shanjiancaofu/smart-gas-monitor/hardware/schematic/原理图.png

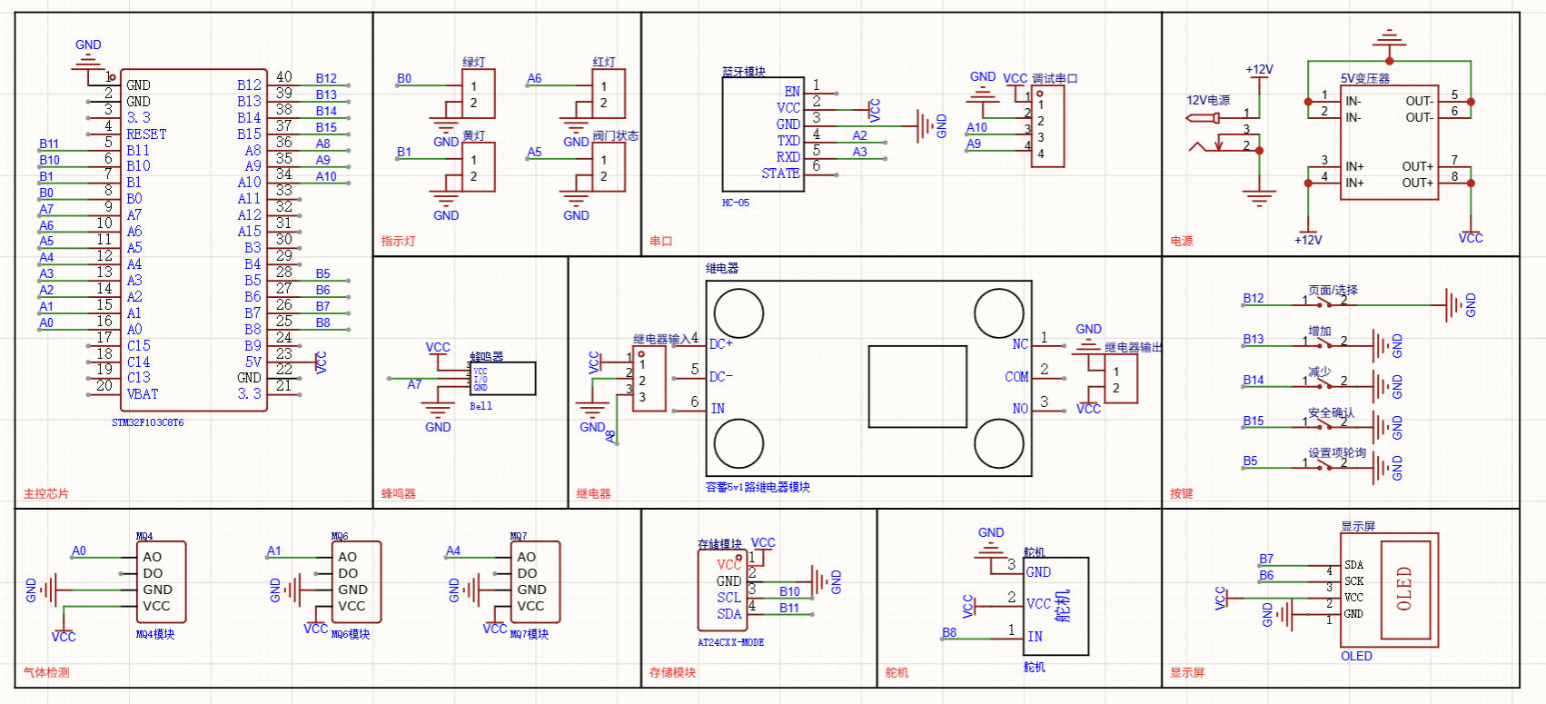
hardware/schematic/原理图.png
