shanjiancaofu/smart-gas-monitor/docs/题目及嵌入式元器件清单.xls

序号 | 自选题目 | 基础功能 | 需要基础元器件 | 型号 | 扩展功能 | 扩展硬件 | 型号
例：第１组 | 智能温度监控系统 | 实时采集、显示环境温度、阈值及系统工作状态；温度超限声光报警 + 风扇自动调节（制冷 / 制热）；按键设置温限阈值，周期性采样（频率可调）；串口上传温度数据至 PC 存储（含报警状态） | 开发板 x1 | STM32F103C8T6 | 蓝牙通信、数据断电存储、多个温度传感器（多点监控）、实现温度自控制 | 蓝牙模块 x1 | HC-06
 |  |  | 温度传感器 x1 | DS18B20 |  | SD 卡模块 x1 | SD卡模块
 |  |  | 蜂鸣器 x1 | 有源/无源蜂鸣器 |  | 按键 x4
 |  |  | LED x3 |  |  | 继电器模块 x1 | 继电器模块
 |  |  | 电机 x1 | 步进电机28BYJ4+ULN2003 |  | 温度传感器 x3 | DS18B20
 |  |  | 电机驱动模块 x1 | L298N模块
 |  |  | 小风扇 x1 | L9110风扇传感器模块
 |  |  | USB 转串口模块 x1 | CH340模块
 |  |  | 按键 x2 | 6*6*5四脚按键
 |  |  | OLED模块 x1 | 0.96寸，4管脚，OLED
 |  |  | 电阻若干
 |  |  | 电容若干
 | 智能燃气监测与自动防护系统 | 实时采集MQ-4、MQ-7、MQ-8三路燃气传感器数据，监测环境燃气浓度； 通过OLED显示燃气浓度、系统运行状态和报警信息； 当燃气浓度超过设定阈值时触发声光报警，并通过继电器模块模拟控制燃气阀门关闭； 支持按键切换工作模式、调整燃气报警阈值； 支持定时采样、串口通信功能。 | STM32F103C8T6开发板 ×1 | STM32F103C8T6 | 增加HC-05蓝牙通信，实现手机APP远程监控；APP端可查看实时燃气浓度、系统运行状态、阀门状态以及历史泄漏事件，并支持远程设置报警阈值、采样周期、报警时间等参数。 增加防误操作设计，燃气报警后关闭阀门，需要按键确认并且燃气浓度恢复正常后才能重新开启。 增加数据存储功能，使用AT24C02 EEPROM保存系统参数和历史泄漏事件，可通过串口查询历史数据并在OLED显示。 | 蓝牙模块 ×1 | HC-05
 |  |  | MQ-4燃气传感器 ×1 | MQ-4 |  | EEPROM存储模块 ×1 | AT24C02
 |  |  | MQ-7燃气传感器 ×1 | MQ-7
 |  |  | MQ-8燃气传感器 ×1 | MQ-8
 |  |  | OLED显示模块 ×1 | 0.96寸 I2C OLED
 |  |  | 有源蜂鸣器 ×1 | 有源蜂鸣器
 |  |  | LED ×3 | LED
 |  |  | 独立按键 ×4 | 两脚按键
 |  |  | 5V继电器模块 ×1 | 5V继电器模块
 |  |  | 电源开关 ×1 | SS-12D06
 |  |  | USB-TTL串口模块 ×1 | CH340 USB-TTL
 |  |  | 电阻若干
