shanjiancaofu/smart-gas-monitor/(list of files, drawings)

Other design files:
hardware/proteus/燃气检测.pdsprj
