shanjiancaofu/smart-gas-monitor/stm32f103/Core/Src/main.c

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
/* Includes ------------------------------------------------------------------*/
#include "main.h"
#include "adc.h"
#include "i2c.h"
#include "tim.h"
#include "usart.h"
#include "gpio.h"

/* USER CODE BEGIN Includes */
#include "app.h"
#include "alarm/alarm.h"
#include "bsp_buzzer.h"
/* USER CODE END Includes */


void SystemClock_Config(void);
/* USER CODE BEGIN 0 */

/* Power is always present in the current hardware.  Hold the application at
 * a safe, inactive startup gate until KEY5 is pressed, then release it
 * before app_init() arms the normal warm-up/monitoring flow. */
static void wait_for_start_key(void)
{
  while (HAL_GPIO_ReadPin(KEY5_GPIO_Port, KEY5_Pin) == GPIO_PIN_SET)
  {
    HAL_Delay(20);
  }
  HAL_Delay(30);
  while (HAL_GPIO_ReadPin(KEY5_GPIO_Port, KEY5_Pin) == GPIO_PIN_RESET)
  {
    HAL_Delay(10);
  }
}

/* USER CODE END 0 */

/**
  * @brief  The application entry point.
  * @retval int
  */
int main(void)
{

  /* MCU Configuration--------------------------------------------------------*/

  /* Reset of all peripherals, Initializes the Flash interface and the Systick. */
  HAL_Init();

  /* Configure the system clock */
  SystemClock_Config();

  /* Initialize all configured peripherals */
  MX_GPIO_Init();
  MX_ADC1_Init();
  MX_I2C1_Init();
  MX_I2C2_Init();
  MX_USART1_UART_Init();
  MX_USART2_UART_Init();
  MX_TIM2_Init();
  MX_TIM4_Init();
  /* USER CODE BEGIN 2 */
  /* MX_GPIO_Init() 里那句 HAL_GPIO_WritePin 把 BUZZER_Pin 也拉低了，那是按高
   * 电平触发生成的。本项目的蜂鸣器低电平触发，所以上电到 alarm_init() 之间它会
   * 一直响；这里先摆回空闲电平，别等 app_init()。 */
  bsp_buzzer_set(false);
  wait_for_start_key();
  if (!app_init())
  {
    Error_Handler();
  }
  /* USER CODE END 2 */

  /* Infinite loop */
  /* USER CODE BEGIN WHILE */
  while (1)
  {
    /* USER CODE END WHILE */

    /* USER CODE BEGIN 3 */
    app_update();
  }
  /* USER CODE END 3 */
}

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
