shanjiancaofu/smart-gas-monitor/stm32f103/smart_gas_monitor.ioc

Mcu.UserName=STM32F103C8Tx
PA0-WKUP.GPIO_Label=MQ4_AO
PA0-WKUP.Signal=ADCx_IN0
PA1.GPIO_Label=MQ6_AO
PA1.Signal=ADCx_IN1
PA10.Signal=USART1_RX
PA13.Signal=SYS_JTMS-SWDIO
PA14.Signal=SYS_JTCK-SWCLK
PA2.Signal=USART2_TX
PA3.Signal=USART2_RX
PA4.GPIO_Label=MQ7_AO
PA4.Signal=ADCx_IN4
PA5.GPIO_Label=VALVE_LED
PA5.Signal=GPIO_Output
PA6.GPIO_Label=LED_RED
PA6.Signal=GPIO_Output
PA7.GPIO_Label=BUZZER
PA7.Signal=GPIO_Output
PA8.GPIO_Label=RELAY
PA8.Signal=GPIO_Output
PA9.Signal=USART1_TX
PB0.GPIO_Label=LED_GREEN
PB0.Signal=GPIO_Output
PB1.GPIO_Label=LED_YELLOW
PB1.Signal=GPIO_Output
PB10.Signal=I2C2_SCL
PB11.Signal=I2C2_SDA
PB12.GPIO_Label=KEY1
PB12.Signal=GPXTI12
PB13.GPIO_Label=KEY2
PB13.Signal=GPXTI13
PB14.GPIO_Label=KEY3
PB14.Signal=GPXTI14
PB15.GPIO_Label=KEY4
PB15.Signal=GPXTI15
PB5.GPIO_Label=KEY5
PB5.Signal=GPXTI5
PB6.Signal=I2C1_SCL
PB7.Signal=I2C1_SDA
PB8.Signal=S_TIM4_CH3
PD0-OSC_IN.Signal=RCC_OSC_IN
PD1-OSC_OUT.Signal=RCC_OSC_OUT
