shanjiancaofu/smart-gas-monitor/stm32f103/Core/Inc/main.h

#define MQ4_AO_Pin GPIO_PIN_0
#define MQ4_AO_GPIO_Port GPIOA
#define MQ6_AO_Pin GPIO_PIN_1
#define MQ6_AO_GPIO_Port GPIOA
#define MQ7_AO_Pin GPIO_PIN_4
#define MQ7_AO_GPIO_Port GPIOA
#define VALVE_LED_Pin GPIO_PIN_5
#define VALVE_LED_GPIO_Port GPIOA
#define LED_RED_Pin GPIO_PIN_6
#define LED_RED_GPIO_Port GPIOA
#define BUZZER_Pin GPIO_PIN_7
#define BUZZER_GPIO_Port GPIOA
#define LED_GREEN_Pin GPIO_PIN_0
#define LED_GREEN_GPIO_Port GPIOB
#define LED_YELLOW_Pin GPIO_PIN_1
#define LED_YELLOW_GPIO_Port GPIOB
#define KEY1_Pin GPIO_PIN_12
#define KEY1_GPIO_Port GPIOB
#define KEY1_EXTI_IRQn EXTI15_10_IRQn
#define KEY2_Pin GPIO_PIN_13
#define KEY2_GPIO_Port GPIOB
#define KEY2_EXTI_IRQn EXTI15_10_IRQn
#define KEY3_Pin GPIO_PIN_14
#define KEY3_GPIO_Port GPIOB
#define KEY3_EXTI_IRQn EXTI15_10_IRQn
#define KEY4_Pin GPIO_PIN_15
#define KEY4_GPIO_Port GPIOB
#define KEY4_EXTI_IRQn EXTI15_10_IRQn
#define RELAY_Pin GPIO_PIN_8
#define RELAY_GPIO_Port GPIOA
#define KEY5_Pin GPIO_PIN_5
#define KEY5_GPIO_Port GPIOB
#define KEY5_EXTI_IRQn EXTI9_5_IRQn
