shanjiancaofu/smart-gas-monitor/tests/test_alarm.c

#include "alarm/alarm.h"
#include "bsp_led.h"
#include "bsp_buzzer.h"
#include "bsp_relay.h"
#include <assert.h>
#include <stdio.h>

static bool relay, servo_open, buzzer, green_led, yellow_led, red_led, valve_led;
void bsp_fan_set(bool on) { relay = on; }
void bsp_servo_set(bool open) { servo_open = open; }
void bsp_buzzer_set(bool on) { buzzer = on; }
void bsp_led_valve(bool open) { valve_led = open; }
void bsp_led_set(bool green, bool yellow, bool red, bool valve)
{
    green_led = green;
    yellow_led = yellow;
    red_led = red;
    valve_led = valve;
}

int main(void)
{
    alarm_t alarm;
    gas_t gas;
    uint32_t start = UINT32_MAX - 250u;

    gas_init(&gas, NULL, 0);
    alarm_init(&alarm);
    /* 正常上电：全部不动作，风扇也不转。排风是 FAULT/ALARM 才有的行为，
     * alarm_force_safe() 那条路径才开风扇，两者不能混。 */
    assert(!relay && !buzzer && !valve_led);
    alarm_update(&alarm, &gas, 0);
    assert(!relay && !servo_open && !valve_led && !buzzer);
    gas.config.lockout = true;
    gas.latched = true;
    alarm_update(&alarm, &gas, 0);
    assert(relay && !servo_open && !valve_led);
    gas.config.lockout = false;
    gas.latched = false;
    gas.state = GAS_NORMAL;
    alarm_update(&alarm, &gas, 0);
    assert(!relay && servo_open && green_led && valve_led && !buzzer);
    gas.state = GAS_WARNING;
    alarm_update(&alarm, &gas, 1);
    assert(!relay && servo_open && yellow_led && !red_led);

    gas.state = GAS_ALARM;
    gas.latched = true;
    gas.alarm_mask = 1u;
    alarm_update(&alarm, &gas, start);
    assert(relay && !servo_open && !valve_led && red_led && buzzer);

    /* 单滴刚好响 BEEP_ON_TICKS 个节拍，之后到下一滴起点之间是安静的。 */
    /* The 10 ms timer ISR must turn the buzzer off even while the main loop
       is blocked in a slow Soft-I2C OLED transfer. */
    alarm_tick_isr(&alarm, start + BEEP_ON_TICKS);
    assert(!buzzer);

    /* 多一路报警会重新起一拍，蜂鸣器立刻再响。 */
    gas.alarm_mask = 3u;
    alarm_update(&alarm, &gas, start + BEEP_ON_TICKS + 10u);
    assert(buzzer);

    /* 默认档位是 5 秒，从重新起拍算起 500 个节拍之后不再响，红灯和关阀保持。
     * 这几个时刻都从 BEEP_* 常量推出来，调档位时测试跟着走。 */
    alarm_update(&alarm, &gas, start + BEEP_ON_TICKS + 10u + 500u);
    assert(!buzzer && red_led && relay);
    alarm_update(&alarm, &gas, start + BEEP_ON_TICKS + 10u + 1000u);
    assert(!buzzer);

    gas.state = GAS_SAFE_WAIT;
    alarm_update(&alarm, &gas, 1000);
    assert(relay && !servo_open && !buzzer && yellow_led);
    gas.state = GAS_FAULT;
    alarm_update(&alarm, &gas, 1001);
    assert(buzzer && relay && !servo_open && red_led);
    alarm_update(&alarm, &gas, 1001u + FAULT_BEEP_ON_TICKS);
    assert(!buzzer && relay && !servo_open && red_led);
    gas.config.buzzer = GAS_BUZZER_OFF;
    alarm_update(&alarm, &gas, 1002);
    assert(!buzzer);
    gas.config.buzzer = GAS_BUZZER_ALWAYS;
    alarm_update(&alarm, &gas, 1001u + 128u * 1000u);
    assert(buzzer);
    alarm_force_safe();
    assert(relay && !buzzer && !valve_led);
    puts("PASS: alarm output mapping/timer/wraparound/off/always/safe");
    return 0;
}
