shanjiancaofu/smart-gas-monitor/tests/test_gas_monitor.c

#include "gas/gas_monitor.h"
#include <assert.h>
#include <stdio.h>
#include <string.h>

static void sample(gas_monitor_t *m, uint32_t now, uint16_t a, uint16_t b, uint16_t c)
{
    uint16_t values[GAS_COUNT] = {a, b, c};
    gas_monitor_sample(m, values, true, now);
}
/* 跑完一次干净的预热；本函数返回时阀门应当已经打开。 */
static void run_to_normal(gas_monitor_t *m, uint32_t start)
{
    uint32_t t;
    gas_monitor_init(m, NULL, start);
    for (t = 0; t <= GAS_WARMUP_MS + GAS_SAFE_HOLD_MS; t += 100)
        sample(m, start + t, 500, 500, 500);
    assert(m->state == GAS_NORMAL);
    assert(gas_monitor_valve_open(m));
}
static void test_states(void)
{
    gas_monitor_t m;
    uint32_t t;
    unsigned i;
    for (i = 0; i < GAS_COUNT; ++i) {
        uint16_t values[GAS_COUNT] = {500, 500, 500};
        run_to_normal(&m, 0);
        values[i] = gas_warning_threshold(m.config.alarm[i]);
        gas_monitor_sample(&m, values, true, 63100);
        assert(m.state == GAS_WARNING && gas_monitor_valve_open(&m));
        values[i] = m.config.alarm[i];
        gas_monitor_sample(&m, values, true, 63200);
        assert(m.state == GAS_ALARM && !gas_monitor_valve_open(&m));
        assert(m.alarm_mask == (1u << i) && m.alarm_count == 1);
        m.dirty = false;
        sample(&m, 63250, values[0], values[1], values[2]);
        assert(m.state == GAS_ALARM && !m.dirty);
        gas_monitor_key(&m, 4, 63250);
        assert(!gas_monitor_valve_open(&m));
        for (t = 63300; t <= 66300; t += 100) sample(&m, t, 500, 500, 500);
        assert(m.state == GAS_SAFE_WAIT && m.reset_ready);
        assert(!gas_monitor_valve_open(&m));
        gas_monitor_key(&m, 4, 66300);
        assert(gas_monitor_valve_open(&m));
    }
    run_to_normal(&m, 0);
    gas_monitor_tick(&m, 63500);
    assert(m.state == GAS_FAULT && !gas_monitor_valve_open(&m));
    assert(m.config.lockout && m.dirty);
    m.dirty = false;
    gas_monitor_tick(&m, 63501);
    assert(!m.dirty);
    sample(&m, 63600, 500, 500, 500);
    gas_monitor_key(&m, 4, 63600);
    assert(!gas_monitor_valve_open(&m));
    gas_monitor_sample(&m, NULL, false, 63700);
    assert(m.state == GAS_FAULT);
    sample(&m, 63800, 4096, 0, 0);
    assert(m.state == GAS_FAULT);
    run_to_normal(&m, 0);
    sample(&m, 64000, 500, 500, 500);
    assert(m.state == GAS_SAFE_WAIT && !gas_monitor_valve_open(&m));
    assert(!m.reset_ready);
    /* 预热计时和安全计时都要跨过回绕点。 */
    run_to_normal(&m, UINT32_MAX - 61000u);
}
static void test_power_up_opens(void)
{
    gas_monitor_t m;
    uint32_t t;
    gas_monitor_init(&m, NULL, 0);
    for (t = 0; t < GAS_WARMUP_MS; t += 100) {
        sample(&m, t, 500, 500, 500);
        assert(m.state == GAS_WARMUP);
        assert(!gas_monitor_valve_open(&m));
    }
    sample(&m, GAS_WARMUP_MS, 500, 500, 500);
    assert(m.state == GAS_NORMAL && gas_monitor_valve_open(&m));
    /* 安全保持窗口是用来解除锁存的，不是开阀的前置条件。 */
    assert(!m.reset_ready);
}
static void test_no_fault_before_first_sample(void)
{
    gas_monitor_t m;
    gas_monitor_init(&m, NULL, 1000);
    gas_monitor_tick(&m, 1000);
    assert(m.state == GAS_WARMUP && !m.latched);
    /* 一旦成功采过样，再丢掉采样就重新算故障。 */
    sample(&m, 1100, 500, 500, 500);
    gas_monitor_tick(&m, 1100 + gas_sample_timeout_ms(&m));
    assert(m.state == GAS_FAULT && m.latched);
}
static void test_failed_attempt_is_a_fault(void)
{
    gas_monitor_t m;
    uint32_t t;
    /* 开机时就坏掉的 ADC 必须报故障，而不是永远停在预热：「还没有读数」和
     * 「读到了一次失败的读数」是两回事。 */
    gas_monitor_init(&m, NULL, 0);
    gas_monitor_sample(&m, NULL, false, 100);
    assert(m.state == GAS_FAULT && m.latched);
    assert(!gas_monitor_valve_open(&m));
    /* 它和其它锁存走同一条恢复规则：先回到洁净空气，再按 KEY4。 */
    for (t = 200; t <= 100000; t += 100) sample(&m, t, 500, 500, 500);
    assert(m.state == GAS_SAFE_WAIT && m.reset_ready);
    assert(!gas_monitor_valve_open(&m));
    gas_monitor_key(&m, 4, 100000);
    assert(gas_monitor_valve_open(&m));
}
static void test_persisted_lockout(void)
{
    gas_monitor_t m;
    gas_config_t c;
    uint32_t t;
    gas_config_defaults(&c);
    c.lockout = true;
    gas_monitor_init(&m, &c, 0);
    assert(m.latched && !gas_monitor_valve_open(&m));
    for (t = 0; t <= GAS_WARMUP_MS + GAS_SAFE_HOLD_MS; t += 100)
        sample(&m, t, 500, 500, 500);
    assert(m.state == GAS_SAFE_WAIT && m.reset_ready);
    gas_monitor_key(&m, 4, GAS_WARMUP_MS + GAS_SAFE_HOLD_MS);
    assert(!m.config.lockout && m.dirty && gas_monitor_valve_open(&m));
}

static void test_low_threshold_recovers(void)
{
    gas_monitor_t m;
    uint32_t t;
    unsigned i;
    run_to_normal(&m, 0);
    gas_monitor_key(&m, 1, 63000);
    for (i = 0; i < 100; ++i) gas_monitor_key(&m, 3, 63000);
    assert(m.config.alarm[GAS_MQ4] == GAS_THRESHOLD_MIN);
    assert(m.state == GAS_ALARM && !gas_monitor_valve_open(&m));
    /* 安全带按比例取，阈值调到量程最底端时洁净空气仍然够得着；若用固定值，
     * 这种情况永远恢复不了。 */
    for (t = 63100; t <= 66100; t += 100) sample(&m, t, 100, 100, 100);
    assert(m.reset_ready);
    assert(m.state == GAS_SAFE_WAIT && !gas_monitor_valve_open(&m));
    gas_monitor_key(&m, 4, 66100);
    assert(gas_monitor_valve_open(&m));
}
static void test_keys(void)
{
    gas_monitor_t m;
    unsigned i;
    run_to_normal(&m, 0);
    gas_monitor_key(&m, 2, 63000);
    assert(!m.dirty);
    gas_monitor_key(&m, 1, 63000);
    gas_monitor_key(&m, 2, 63000);
    assert(m.config.alarm[GAS_MQ4] == 2450 && m.dirty);
    assert(!gas_monitor_save_due(&m, 64999));
    assert(gas_monitor_save_due(&m, 65000));
    for (i = 0; i < 100; ++i) gas_monitor_key(&m, 2, 63000);
    assert(m.config.alarm[GAS_MQ4] == GAS_THRESHOLD_MAX);
    for (i = 0; i < 100; ++i) gas_monitor_key(&m, 3, 63000);
    assert(m.config.alarm[GAS_MQ4] == GAS_THRESHOLD_MIN);
    assert(m.state == GAS_ALARM && !gas_monitor_valve_open(&m));
}
static void test_sample_period(void)
{
    gas_monitor_t m;
    gas_config_t c;
    uint32_t t;
    unsigned i;
    gas_config_defaults(&c);
    assert(c.sample_period_ms == 100 && gas_config_valid(&c));
    c.sample_period_ms = 0;
    assert(!gas_config_valid(&c));
    c.sample_period_ms = GAS_PERIOD_MAX_MS + 1u;
    assert(!gas_config_valid(&c));

    run_to_normal(&m, 0);
    for (i = 0; i < GAS_SEL_PERIOD; ++i) gas_monitor_key(&m, 1, 63000);
    assert(m.selected == GAS_SEL_PERIOD);
    gas_monitor_key(&m, 2, 63000);
    assert(m.config.sample_period_ms == 200 && m.dirty);
    assert(gas_sample_timeout_ms(&m) == 600);
    /* 停顿判定的窗口跟着配置的采样周期走，不是一个固定常数。 */
    for (t = 63100; t <= 66900; t += 200) sample(&m, t, 500, 500, 500);
    assert(m.state == GAS_NORMAL);
    gas_monitor_tick(&m, 66900 + 599u);
    assert(m.state == GAS_NORMAL);
    gas_monitor_tick(&m, 66900 + 600u);
    assert(m.state == GAS_FAULT && !gas_monitor_valve_open(&m));
}
/* 取值 → 毫秒 → 名字这条链，以及它在两端和越界处的行为。 */
static void test_buzzer_value(void)
{
    gas_config_t c;
    char name[16];
    char tiny[2];

    gas_config_defaults(&c);
    assert(c.buzzer == 5u && gas_config_valid(&c));
    c.buzzer = GAS_BUZZER_ALWAYS;
    assert(gas_config_valid(&c));
    /* 61 是「一直响」的编码，不是「61 秒」；再往上就没有定义了。 */
    c.buzzer = GAS_BUZZER_ALWAYS + 1u;
    assert(!gas_config_valid(&c));

    c.buzzer = GAS_BUZZER_OFF;
    assert(gas_buzzer_duration_ms(&c) == 0u);
    c.buzzer = 1u;
    assert(gas_buzzer_duration_ms(&c) == 1000u);
    c.buzzer = 60u;
    assert(gas_buzzer_duration_ms(&c) == 60000u);
    c.buzzer = GAS_BUZZER_ALWAYS;
    assert(gas_buzzer_duration_ms(&c) == GAS_BUZZER_FOREVER_MS);
    /* 越界的值一律读作「一直响」。若先相乘再截断，66 会回绕成 464 毫秒——
     * 报警路径上最不该出现的失败方式，就是响了 0.5 秒然后安静下来。 */
    c.buzzer = 66u;
    assert(gas_buzzer_duration_ms(&c) == GAS_BUZZER_FOREVER_MS);
    c.buzzer = 255u;
    assert(gas_buzzer_duration_ms(&c) == GAS_BUZZER_FOREVER_MS);

    gas_buzzer_name(GAS_BUZZER_OFF, name, sizeof(name));
    assert(strcmp(name, "OFF") == 0);
    gas_buzzer_name(1u, name, sizeof(name));
    assert(strcmp(name, "1S") == 0);
    gas_buzzer_name(60u, name, sizeof(name));
    assert(strcmp(name, "60S") == 0);
    gas_buzzer_name(GAS_BUZZER_ALWAYS, name, sizeof(name));
    assert(strcmp(name, "ALWAYS") == 0);
    /* 越界同样读作最长档，而不是印出 "66S" 这种根本不存在的设置。 */
    gas_buzzer_name(66u, name, sizeof(name));
    assert(strcmp(name, "ALWAYS") == 0);

    /* 缓冲区不够时截断，不越界；大小为 0 时一个字节都不写。 */
    tiny[0] = (char)0x7f;
    tiny[1] = (char)0x7f;
    gas_buzzer_name(60u, tiny, sizeof(tiny));
    assert(tiny[0] == '6' && tiny[1] == '\0');
    name[0] = 'X';
    gas_buzzer_name(GAS_BUZZER_OFF, name, 0u);
    assert(name[0] == 'X');
}

/* 面板上的按键：在同一个数轴上加减，两端夹取，不环绕。 */
static void test_buzzer_keys(void)
{
    gas_monitor_t m;
    unsigned i;
    run_to_normal(&m, 0);
    for (i = 0; i < GAS_SEL_BUZZER; ++i) gas_monitor_key(&m, 1, 63000);
    assert(m.selected == GAS_SEL_BUZZER);
    m.dirty = false;

    /* 加号一路加到顶就停在「一直响」：加的语义永远是「响得更久」，不做环绕
     * 回到「不响」——那会让同一个按键在两端之间来回跳。 */
    for (i = 0; i < 100; ++i) gas_monitor_key(&m, 2, 63000);
    assert(m.config.buzzer == GAS_BUZZER_ALWAYS && m.dirty);
    gas_monitor_key(&m, 2, 63000);
    assert(m.config.buzzer == GAS_BUZZER_ALWAYS);

    for (i = 0; i < 100; ++i) gas_monitor_key(&m, 3, 63000);
    assert(m.config.buzzer == GAS_BUZZER_OFF);
    gas_monitor_key(&m, 3, 63000);
    assert(m.config.buzzer == GAS_BUZZER_OFF);

    /* 一步一格，中间没有跳档：OFF → 1S → 2S → … → 60S → ALWAYS。 */
    gas_monitor_key(&m, 2, 63000);
    assert(m.config.buzzer == 1u);
    gas_monitor_key(&m, 2, 63000);
    assert(m.config.buzzer == 2u);
    for (i = 0; i < GAS_BUZZER_MAX_S - 2u; ++i) gas_monitor_key(&m, 2, 63000);
    assert(m.config.buzzer == GAS_BUZZER_MAX_S);
    gas_monitor_key(&m, 2, 63000);
    assert(m.config.buzzer == GAS_BUZZER_ALWAYS);
    gas_monitor_key(&m, 3, 63000);
    assert(m.config.buzzer == GAS_BUZZER_MAX_S);

    /* 改蜂鸣器时长不影响别的设置项，别的设置项也不影响它。 */
    assert(m.config.alarm[GAS_MQ4] == 2400u);
    assert(m.config.sample_period_ms == 100u);
}

static void test_buzzer_set(void)
{
    gas_monitor_t m;
    uint32_t t;
    unsigned i;
    char name[16];

    run_to_normal(&m, 0);
    /* 60 以内逐档都对，61 是「一直响」。 */
    assert(gas_monitor_set_buzzer(&m, 1u, 63000) && m.config.buzzer == 1u);
    assert(gas_monitor_set_buzzer(&m, GAS_BUZZER_MAX_S, 63000));
    assert(m.config.buzzer == GAS_BUZZER_MAX_S);
    assert(gas_monitor_set_buzzer(&m, GAS_BUZZER_ALWAYS, 63000));
    assert(m.config.buzzer == GAS_BUZZER_ALWAYS);
    assert(gas_monitor_set_buzzer(&m, GAS_BUZZER_OFF, 63000));
    assert(m.config.buzzer == GAS_BUZZER_OFF && gas_buzzer_duration_ms(&m.config) == 0u);

    /* 超出编码范围的值必须在收窄成 uint8 之前就被拒：256 截断成 0 会成为
     * 一个合法取值，静默地把蜂鸣器关掉，而调用者要的显然不是这个。 */
    assert(!gas_monitor_set_buzzer(&m, GAS_BUZZER_ALWAYS + 1u, 63000));
    assert(!gas_monitor_set_buzzer(&m, 256u, 63000));
    assert(!gas_monitor_set_buzzer(&m, 0xffffu, 63000));
    assert(m.config.buzzer == GAS_BUZZER_OFF);

    /* 面板上显示的名字就是串口回显的名字，两边共用一份拼写。 */
    gas_buzzer_name(m.config.buzzer, name, sizeof(name));
    assert(strcmp(name, "OFF") == 0);

    /* 蜂鸣器时长不参与限值判断，所以调它不重启「低于危险阈值多久算恢复」那个
     * 窗口：重启只会让站在 SAFE_WAIT 里等 KEY4 的人白等三秒。阈值参与，调它
     * 就必须重启。 */
    gas_monitor_key(&m, 1, 63000);
    for (i = 0; i < 100u; ++i) gas_monitor_key(&m, 3, 63000);
    for (t = 63100; t <= 66100; t += 100) sample(&m, t, 100, 100, 100);
    assert(m.state == GAS_SAFE_WAIT && m.reset_ready);

    m.dirty = false;
    assert(gas_monitor_set_buzzer(&m, 30u, 66101));
    assert(m.dirty && m.reset_ready);
    assert(gas_monitor_set_threshold(&m, GAS_MQ4, 2600u, 66101));
    assert(!m.reset_ready);
    /* 窗口从改动那一刻重新开始计时，之后照常成立。 */
    for (t = 66200; t <= 69200; t += 100) sample(&m, t, 100, 100, 100);
    assert(m.reset_ready);
    gas_monitor_key(&m, 4, 69200);
    assert(gas_monitor_valve_open(&m));
}

int main(void)
{
    test_buzzer_value();
    test_buzzer_keys();
    test_buzzer_set();
    test_states();
    test_power_up_opens();
    test_no_fault_before_first_sample();
    test_failed_attempt_is_a_fault();
    test_persisted_lockout();
    test_low_threshold_recovers();
    test_keys();
    test_sample_period();
    puts("PASS: gas_monitor states/power-up/fault/recovery/keys/period/buzzer/wraparound");
    return 0;
}
