shanjiancaofu/smart-gas-monitor/(commit log)

2026-09-14 [refactor]: split gas_board into bsp modules, reorganize app layout, fix recovery lockup
    [app.c, app.h, gas_monitor.c, key.c, key.h, main.c, run_host_tests.py, test_gas.c]
2026-09-14 [fix]: treat a failed first sample as a fault and align period minimum to 100ms
    [gas_monitor.c, test_gas_monitor.c]
2026-09-14 [feature]: average eight ADC conversions and bound the buzzer in time
    A single conversion moved the reported value by tens of counts between sample
    periods, which is enough to sit on a threshold and chatter. Each channel is now
    converted eight times and the mean is what the state machine sees.
    The buzzer used to sound for as long as the alarm held. It is now driven for a
    fixed five seconds from the start of an alarm, so a fault is noticed once and
    then stays quiet while the valve stays shut.
    The BSP drives its pins through the CubeMX User Label macros, so moving a pin in
    the .ioc breaks the build instead of silently killing an output. The regenerated
    tree carries those labels and raises I2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
    [key.c, main.c, main.h, smart_gas_monitor.ioc]
2026-09-14 [feature]: add the OLED pages and the EEPROM alarm log
    The panel shows exactly three pages, cycled by KEY1: the live reading as
    channel/threshold pairs with the state and valve position, the adjustable
    settings with the selected row marked, and the alarm log.
    The driver owns a 1 KB buffer and pushes only the pages whose bytes changed, so
    a repaint that alters one number costs one page of I2C rather than eight. Rows
    are padded to the full width so a shrinking value overwrites the longer one it
    replaced instead of leaving its tail behind.
    The log lives at 0x20..0xff, which is fourteen 16-byte records, each with a
    sequence number, the power-on seconds at which it was raised, the three ADC
    val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
    [app.c, app.h, display.c, display.h, gas_monitor.c, run_host_tests.py]
2026-09-14 [feature]: put the text protocol on both serial links
    The USB-TTL adapter and the HC-05 radio carry the same commands, so one parser
    serves both and neither link can do anything the other cannot.
    Both directions are interrupt driven. Transmitting a fourteen-record history
    dump from inside the main loop would take about 780 ms at the radio's 9600 baud,
    which is longer than the sampler's own fault timeout at a short period: the
    sending itself would have tripped a FAULT and shut the valve. Instead a reply is
    emitted one line at a time, and only when both links are idle, so the protocol
    costs the loop nothing it can notice.
    Commands are STATUS?, CONFIG?, HISTORY?, SET MQ4|MQ7|MQ8|PERIOD <n> an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
    [app.c, app.h, display.c, gas_monitor.c, main.c, protocol.c, protocol.h, run_host_tests.py]
2026-09-14 [docs]: record the panel, the alarm log and the serial protocol
    The three commits that finished the software (fe153fd, 4d8c404, 8fdcf1f)
    went in without their write-up. This adds them to the changelog, brings the
    layering table, the peripheral table and the parameter map up to date, and
    records a fresh clean build with all four host suites passing.
    The verification entry also writes down the reasoning behind the decisions a
    compile cannot check: a history dump is emitted one line at a time so that
    answering HISTORY? cannot trip the sampler's own fault timeout, a remote SET
    goes through the same validation as a keypress so it cannot store a
    configuration the decoder would reject on the next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
2026-09-14 [docs]: add the Proteus setup and the demonstration script
    Proteus has no model for any of the three gas sensors, for the HC-05, or
    reliably for the SSD1306, so the simulation has to be assembled around
    substitutes. This writes down which substitute stands in for which part and
    what it therefore cannot prove.
    The three potentiometers drive the real 10k/18k divider rather than a
    pre-scaled voltage, so the simulation matches the schematic that is about to
    be drawn and checks the divider values as a side effect. A conversion table
    turns each threshold into the voltage to set, since the numbers the firmware
    compares are ADC counts and nobody can eyeball those on a dial.
    The demonstration scrip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
2026-09-14 fix: finalize persistent valve lockout
    [app.c, app.h, display.c, gas_monitor.c, test_gas_monitor.c, test_protocol.c, test_settings.c]
2026-09-14 [docs]: follow the persistent lockout in the Proteus procedure
    The valve latch now lives in the EEPROM, so the demonstration script was
    describing behaviour the firmware no longer has in two places: a power-up
    with a stored lockout does not open the valve at the end of warm-up, and the
    power cycle that used to only prove the thresholds persisted now also has to
    prove the valve stayed shut.
    That changes what the AT24C02 model has to do for the simulation to mean
    anything, so the note about its retention now says to measure it first and
    what each outcome implies, rather than treating it as an aside.
2026-09-14 [docs]: write the app and bsp comments in Chinese
    The comments in app/ and bsp/ were the last English left in the tree; the
    docs, the changelog and the Proteus guide are all Chinese, so a reader
    following one of those into the source hit a language change at the file
    boundary. Every comment is now Chinese, keeping what each one explains
    rather than shortening it: the timing argument in key.c, the two-copy
    commit order in at24c02.c, the ring-buffer mask reasoning in serial.c and
    the rest.
    Only comment text moved. String literals and _Static_assert messages stay
    English, since they are code and the assert text is meant to be read in a
    build log next to the compiler's own output.
    Two independ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
    [app.c, app.h, display.c, display.h, gas_monitor.c, key.c]
2026-09-14 [docs]: give the freeze entry its commit hash
    The section was written as 待提交 in the same commit that landed the work
    it describes, so it has been claiming unfinished status for changes that
    have been in the tree since 1a2a923. It now carries the hash like every
    other entry, which is what the file's own opening paragraph promises the
    reader: 每条附提交短哈希.
2026-09-14 [docs]: write the host test comments in Chinese
    Follows 80ba876, which left tests/ as the last English in the tree. The
    comments here carry the same kind of reasoning as the ones in app/ and
    bsp/ — why the newer config slot must not take the good one down with it,
    why a torn write must not consume a sequence number, why a remote close
    has no remote counterpart — so they are translated rather than trimmed.
    Checked the same way: stripping comments and collapsing whitespace from
    all four files leaves code byte-identical to HEAD, and all four suites
    still build and pass under MSVC with /W4 /WX.
    Only tests/ moved; the firmware sources are untouched, so the image is
    still 49d78ed3244f58ec23c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
2026-09-14 [fix]: silence the buzzer in alarm_output_force_safe
    force_safe() only drove the relay and the valve indicator. It is called
    from Error_Handler and the five fault handlers, and none of those paths
    run alarm_output_apply() afterwards, so the buzzer pin stayed at whatever
    level was last written to it: a HardFault landing inside the buzzer
    window left it sounding until reset.
    Drive the buzzer to its off level there too, and drop the now-redundant
    write in alarm_output_init(), which reaches the pin through force_safe.
    This makes a hardware fault silent on the spot. That is the right trade
    for a pin that would otherwise be stuck, but it is a deliberate choice,
    so it is kept in its own commit.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
2026-09-14 [feature]: make the alarm buzzer duration configurable
    The buzzer sounded for a fixed 5 seconds. It is now a setting with three
    positions on one number line, so that "up" always means "longer":
    0 GAS_BUZZER_OFF silent
    1..60 seconds
    61 GAS_BUZZER_ALWAYS until the alarm clears
    The key handler is therefore add, subtract, clamp at both ends - no
    table, no wrap-around. gas_buzzer_duration_ms() converts the value to
    the milliseconds alarm_output_apply() wants, mapping ALWAYS to a
    sentinel the BSP treats as "no expiry"; anything out of range also reads
    as ALWAYS, so a bad byte can never wrap into a duration of a few hundred
    milliseconds. That conversion lives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
    [app.c, display.c, gas_monitor.c, protocol.c, test_gas_monitor.c, test_protocol.c, test_settings.c]
2026-09-15 [refactor]: split the firmware into app modules and bsp_* drivers
    The application layer is now one module per job - gas, alarm, config,
    history, protocol, display - and the board layer is nine bsp_* drivers.
    main() calls app_init() and app_update(); the application object lives
    inside app.c.
    Three of the changes are not moves, and they are the ones worth reviewing:
    - The eight-sample average left the BSP. bsp_adc_read() now reads one
    hardware channel at a time and knows nothing about MQ4/MQ7/MQ8; the
    channel map and the averaging live in gas_read_samples().
    - The buzzer timing window left the BSP. alarm_t{active, started_tick}
    replaced the two statics that held it, and bsp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
    [alarm.c, alarm.h, app.c, app.h, bsp_adc.c, bsp_adc.h, bsp_buzzer.c, bsp_buzzer.h]
2026-09-15 [refactor]: let the composer own the OLED panel
    display used to embed a bsp_oled_t and call bsp_oled_init() on it, so its
    own header took an I2C_HandleTypeDef * - the only HAL type named anywhere
    in the display module, and a HAL dependency for a module whose entire job
    is drawing.
    The panel now lives in app_t alongside sensor, eeprom, keys and the two
    uarts, and display_init() receives the built object instead:
    bsp_oled_init(&app->oled, oled);
    display_init(&app->display, &app->oled);
    Readiness moved with it. bsp_oled_t gained a ready field and
    bsp_oled_is_ready() reports it, so display_t no longer keeps a second
    copy of a fact the BSP already knows; display_update() asks the BSP.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
    [app.c, bsp_oled.c, bsp_oled.h, display.c, display.h]
2026-09-15 [docs]: add the assignment topics and embedded component list
    [题目及嵌入式元器件清单.xls]
2026-09-16 fix: keep Keil ArmCC build compatible
    [app.c, bsp_key.c, display.c]
2026-09-16 [fix]: handle blank EEPROM and alarm warmup edges
    [alarm.c, alarm.h, app.c, gas.c]
2026-09-16 [fix]: align OLED paging and fault display
    [app.c, bsp_oled.c, display.c, display.h, test_history.c]
2026-09-16 [fix]: harden fault signaling and history recovery
    [alarm.c, bsp_uart.c]
2026-09-16 [fix]: isolate USB and radio protocol queues
    [app.c]
2026-09-16 [fix]: distinguish empty EEPROM from I/O failure
    [app.c]
2026-09-16 [docs]: update hardware wiring document
2026-09-16 [docs]: replace hardware docx with current wiring markdown
2026-09-16 [fix]: remap OLED I2C to PB8 and PB9
    [main.h, smart_gas_monitor.ioc]
2026-09-16 [fix]: enlarge OLED UI text and simplify pages
    [display.c]
2026-09-16 [fix]: enlarge OLED pages to four-line layout
    [display.c]
2026-09-16 [fix]: replace corrupt OLED font tables
    [bsp_oled.c, gen_oled_font.py]
2026-09-16 [fix]: keep a missing EEPROM from stalling start-up
    [app.c, smart_gas_monitor.ioc]
2026-09-16 [feat]: raise demo thresholds to 2400 and shorten warm-up to 3 s
    [test_display.c, test_gas.c, test_protocol.c]
2026-09-16 [fix]: show every settings item on the OLED
    [display.c, test_display.c]
2026-09-16 [fix]: correct I2C pins, bus speed and UART RX pull-ups
    [smart_gas_monitor.ioc]
2026-09-16 [fix]: drive the buzzer as active-low
    [bsp_buzzer.h, main.c]
2026-09-16 [docs]: update wiring, power and Proteus documentation
2026-09-16 [chore]: add the serial check script and the Proteus project
    [燃气检测.pdsprj]
2026-09-16 [docs]: record the OLED verification on the default I2C1 pins
2026-09-16 feat: finalize fan and servo safety actuators
    [燃气检测.pdsprj]
2026-09-16 [fix]: guard the servo write against a gated TIM4 clock
    [bsp_servo.c]
2026-09-16 [refactor]: drop the unused relay open/close wrappers
2026-09-16 [docs]: update the Proteus guide for the fan and servo actuators
2026-09-16 [fix]: wire the fan relay to PA8 in the Proteus schematic
    [燃气检测.pdsprj]
2026-09-16 [docs]: document the lockout persistence and servo wiring
2026-09-16 [fix]: repair the corrupted comment encoding in app.c and main.c
    [app.c, main.c]
2026-09-16 [docs]: match the I2C1 clock comment to its value
2026-09-16 [fix]: move the TIM4 servo setup out of CubeMX's reach
    [bsp_servo.c]
2026-09-16 [chore]: register the servo source in the Keil project
2026-09-16 [fix]: set the I2C1 clock to 100 kHz for the simulation model
2026-09-16 [fix]: drive both I2C buses with software bit-banging
    [app.c, bsp_i2c.c, bsp_i2c.h, main.c]
2026-09-16 [fix]: release SDA for ACK/read and slow the bit-banged bus
    [bsp_i2c.c, bsp_oled.c]
2026-09-16 [fix]: take key events from the edge so short presses are not lost
    [bsp_key.c, bsp_key.h]
2026-09-16 [fix]: lengthen the alarm beep to 500 ms
    [alarm.c, alarm.h, test_alarm.c]
2026-09-16 [fix]: stop floating I2C lines from faking an acknowledge
    [bsp_i2c.c]
2026-09-16 [fix]: bound the display flush so sampling keeps its deadline
    [bsp_oled.c, bsp_oled.h, display.c, test_display.c]
2026-09-16 [fix]: raise the bit-banged I2C clock to about 80 kHz
    [bsp_i2c.c]
2026-09-16 [fix]: size the sample timeout above the longest blocking refresh
    [display.c, test_gas.c]
2026-09-16 [fix]: hold the start and stop conditions longer than the data bits
    [bsp_i2c.c]
2026-09-16 [fix]: slow every bit to satisfy the Proteus memory model
    [bsp_i2c.c]
2026-09-16 [fix]: count the bit delay in executed instructions, not loop turns
    [bsp_i2c.c]
2026-09-17 [fix]: retry the EEPROM acknowledge poll instead of probing once
    [bsp_eeprom.c, bsp_eeprom_config.h, bsp_i2c.c]
2026-09-17 [fix]: size the sample timeout as a period plus a fixed margin
    [bsp_oled.h, gas.c, test_gas.c]
2026-09-17 [fix]: keep the exhaust running in the force-safe path
    [alarm.c, test_alarm.c]
2026-09-17 [fix]: put KEY5 on EXTI like the other four keys
    [bsp_key.c, bsp_key.h]
2026-09-17 [feat]: show the storage state and the lockout stage on the OLED
2026-09-17 [chore]: rename the I2C delay constant and correct its comment
    [bsp_i2c.c]
2026-09-17 [fix]: stop the exhaust fan from running during a normal start-up
    [alarm.c, test_alarm.c]
2026-09-17 [fix]: report a failed servo PWM start-up instead of ignoring it
    [app.c, bsp_servo.c]
2026-09-17 [fix]: name the locked-out state SAFE_WAIT in the protocol too
    [gas.c]
2026-09-17 feat: finalize CubeMX and dual I2C build matrix
2026-09-17 chore: update Proteus hardware project
    [燃气检测.pdsprj]
2026-09-17 fix: add Proteus key polling fallback
    [bsp_key.c]
2026-09-17 fix: stabilize SAFE_WAIT readiness with hysteresis
    [gas.c, test_gas.c]
2026-09-17 chore: update Proteus simulation project
    [燃气检测.pdsprj]
2026-09-17 fix: sharpen alarm cadence and widen servo travel
    [alarm.c, alarm.h, bsp_servo.c, smart_gas_monitor.ioc, test_alarm.c]
2026-09-17 tune: lengthen buzzer pattern gaps
    [alarm.h]
2026-09-17 fix: add software servo PWM for Proteus
    [bsp_servo.c]
2026-09-17 fix: align servo PWM with verified reference
    [bsp_servo.c, smart_gas_monitor.ioc]
2026-09-17 fix: keep simulation outputs responsive during I2C
    [alarm.c, alarm.h, app.c, bsp_servo.c, display.c, test_alarm.c]
2026-09-17 fix: match Proteus servo pulse range
    [bsp_servo.c]
2026-09-17 feat: simplify buzzer setting codes
    [gas.c, test_config.c, test_gas.c, test_protocol.c]
2026-09-17 refactor: unify servo PWM across targets
2026-09-18 fix: drive the simulated servo from TIM2_CH2 on PA1
    Proteus's STM32 model does not implement TIM4_CH3 on PB8, so the servo
    never moved in simulation. Both working reference projects drive it from
    TIM2_CH2 / PA1, and TIM2 is implemented -- the 10 ms system tick has
    always run on it. Pulse widths stay 500 / 2500 us on both sides.
    The simulation and hardware builds now use different pins. The hardware
    build is unchanged in behaviour; every difference is confined to
    `#if USE_SOFT_I2C` in bsp/, plus the ADC channel table in gas.c.
    servo timer MQ6 valve LED
    soft (Proteus) PA1 TIM2_CH2 PA5 PB9
    hw (board) PB8 TIM4_CH3 PA1 PA5
    PA1 had to be freed for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
    [燃气检测.pdsprj]
2026-09-18 docs: restore the garbled comments and correct the build notes
    c9ee996 ("finalize CubeMX and dual I2C build matrix") mangled every
    Chinese comment in the files it touched -- UTF-8 read back as GBK. This
    repo had already hit the same thing once (24f81e4). The affected files
    are app.c, config.h, bsp_i2c.c, bsp_key.c, main.c and test_config.c.
    Rather than reconstruct the comments by eye, each file was restored from
    its last clean revision:
    - bsp_i2c.c was rebuilt from de89d62 and the three real changes made
    since then were re-applied by hand (the USE_SOFT_I2C guard, the
    hardware branch, and the HAL_I2C_DeInit block). That also recovered
    a dozen comments I had not noticed were damaged.
    -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
    [app.c, bsp_i2c.c, bsp_key.c, main.c, test_config.c]
